yyzkevin/PicoPCMCIA-Breakout/hw/Breakout.step

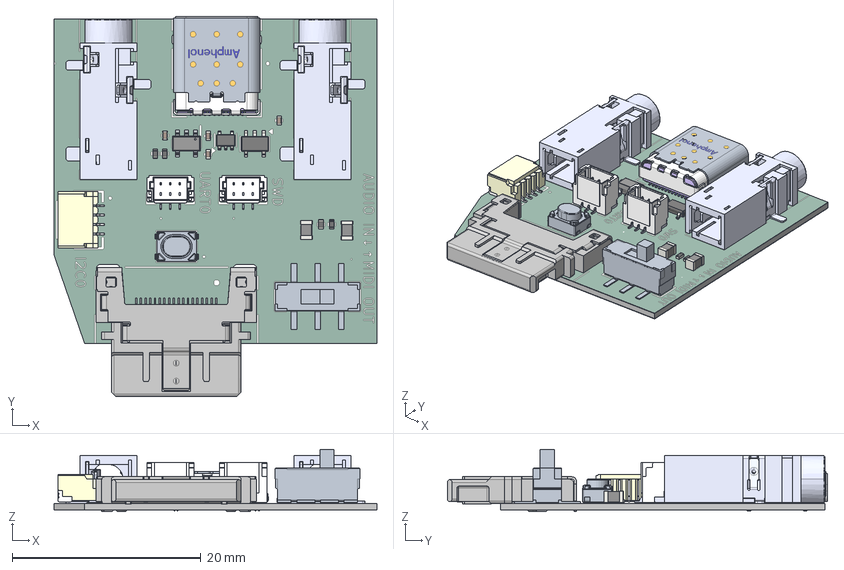
[picture p1: CAD file, 2026-10-23]
hw/Breakout.step
34.2 x 40.3 x 6.60 mm
SJ-3523-SMT-TR x 2
ST60X-18S
BMxxB-SRSS-TB(LF)(SN)_03 x 2
R_0402_1005Metric x 4
PinsArrayL
PinsArrayR
L_0805_2012Metric x 2
C_0402_1005Metric x 4
SOT-353_SC-70-5
Breakout 1.15
TSOT-23-5
664_12401610E4%232A
JS202011SCQN
SM04B-SRSS-TB
Breakout_silkscreen
Breakout_soldermask
Breakout_PCB
