yyzkevin/PicoPCMCIA-Breakout/hw/Breakout.kicad_pcb

## KiCad design hw/Breakout.kicad_pcb (2026-11-13)

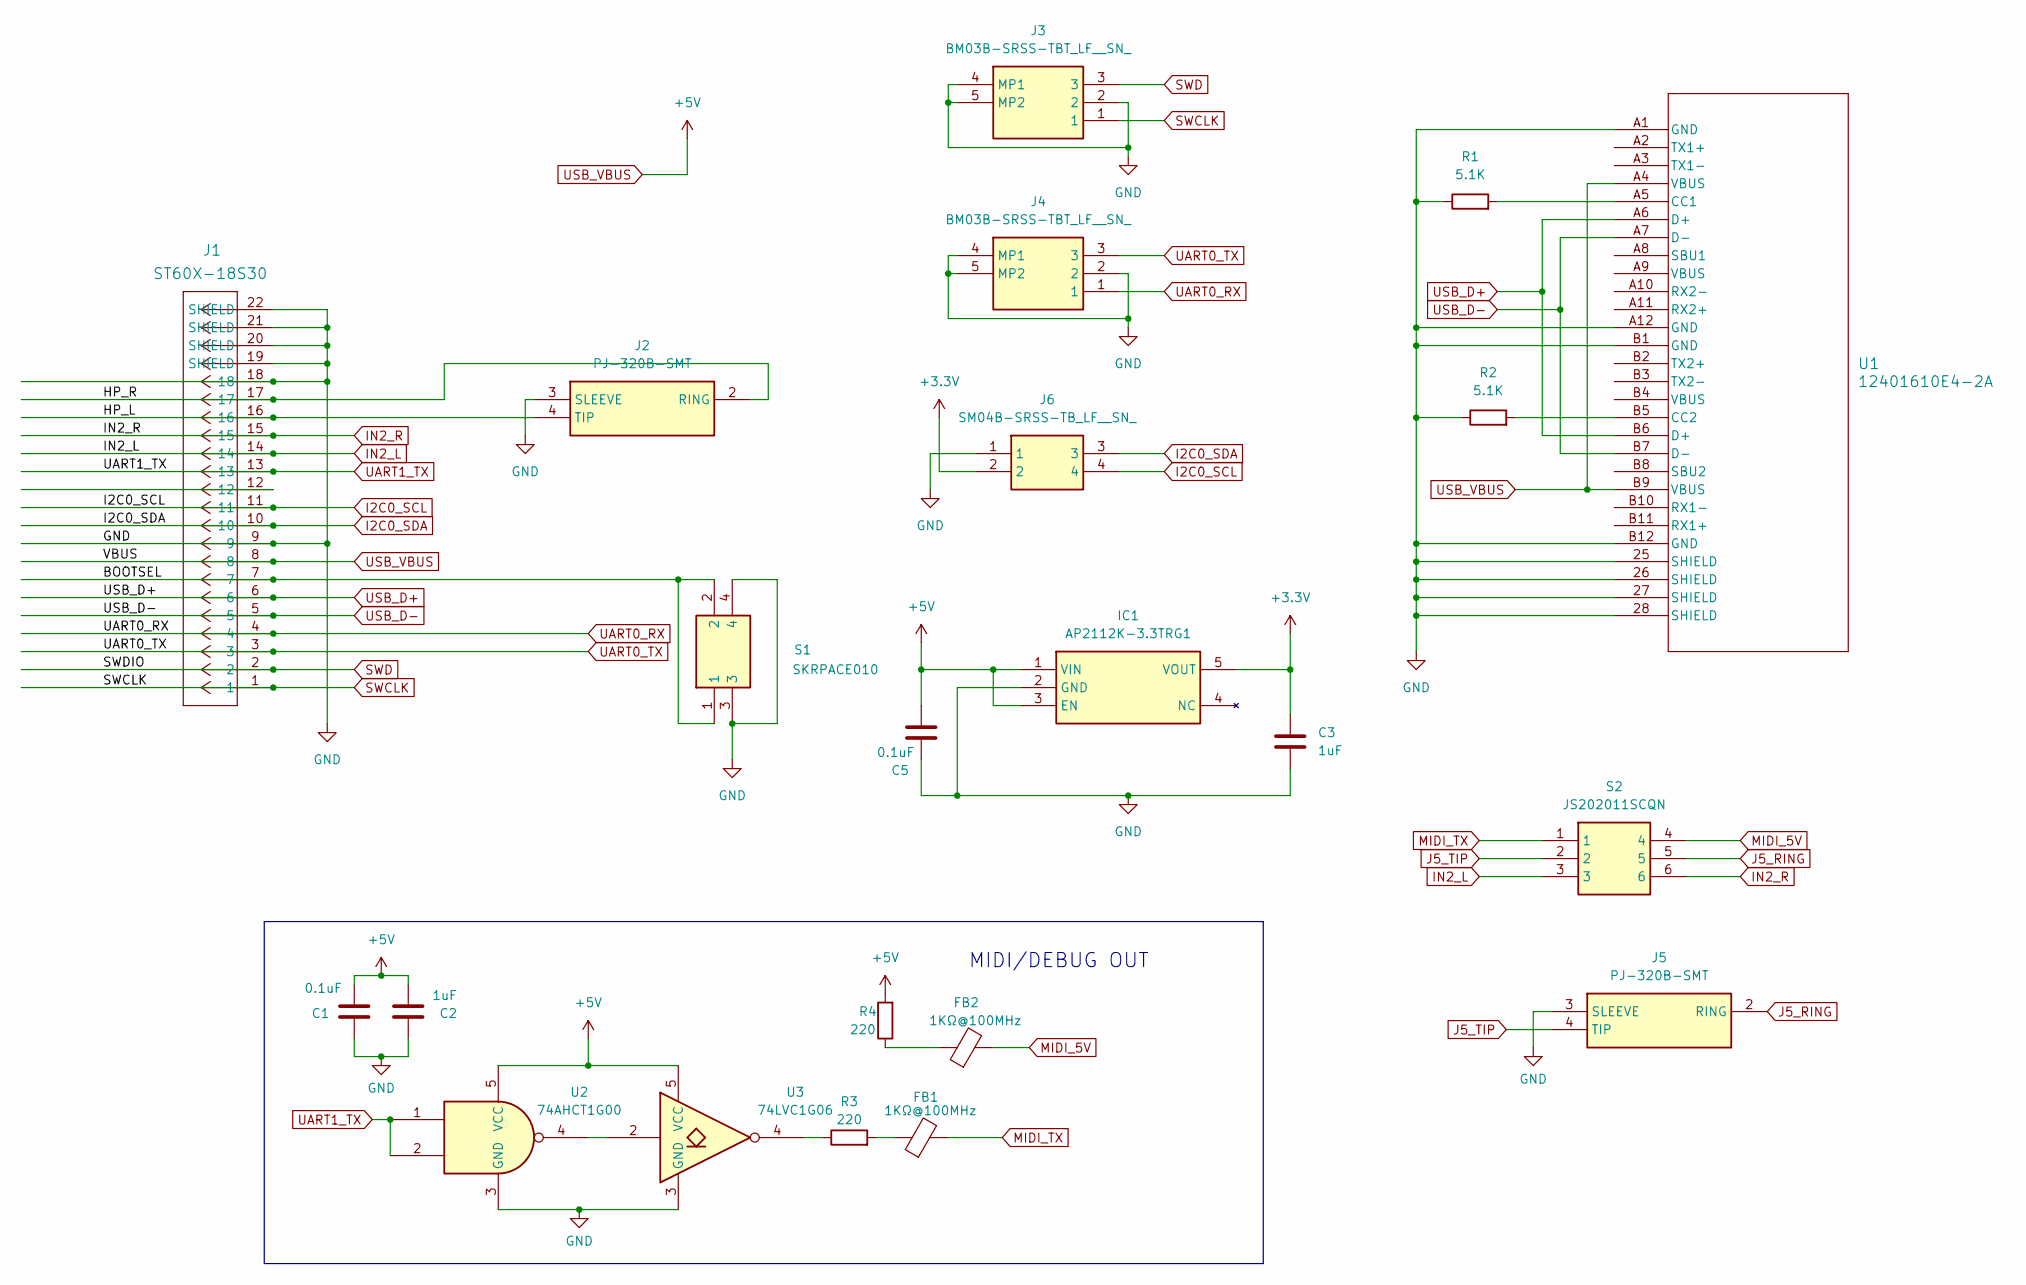
[picture p2: schematic Breakout.kicad_sch]

Parts:
C1, C5: 0.1uF; C_0402_1005Metric; LCSC C1525
C2, C3: 1uF; C_0402_1005Metric; LCSC C52923
FB1, FB2: 1KΩ@100MHz; L_0805_2012Metric; LCSC C85835
IC1: AP2112K-3.3TRG1; SOT95P285X140-5N; Mouser Part Number 621-AP2112K-3.3TRG1
J1: ST60X-18S30; CONN18_0X-18S30_HIR; LCSC C21136285
J2, J5: PJ-320B-SMT; Manufacturer_Part_Number PJ-320B-SMT; LCSC C2884998
J3, J4: BM03B-SRSS-TBT_LF__SN_; BM03BSRSSTBTLFSN; Mouser Part Number N/A
J6: SM04B-SRSS-TB_LF__SN_; SM04B-SRSS-TB_LFSN_; Mouser Part Number 306-SM04BSRSSTBLFSN
R1, R2: 5.1K; R_0402_1005Metric; LCSC C25905
R3, R4: 220; R_0402_1005Metric; LCSC C25091
S1: SKRPACE010; SMT_4.2X3.2_; Mouser Part Number 688-SKRPACE010
S2: JS202011SCQN; Mouser Part Number 611-JS202011SCQN
U1: 12401610E4-2A; 12401610E4-2A_AMP; LCSC C5119948
U2: 74AHCT1G00; SOT-353_SC-70-5; LCSC C7483
U3: 74LVC1G06; TSOT-23-5; LCSC C840103

Connections:
+3.3V: C3.1, IC1.5 (VOUT), J6.2
/BOOTSEL: J1.7, S1.1, S1.2
/HP_L: J1.16, J2.4 (TIP)
/HP_R: J1.17, J2.2 (RING)
GND: C1.2, C2.2, C3.2, C5.2, IC1.2 (GND), J1.9, J1.18, J1.19 (SHIELD), J1.20 (SHIELD), J1.21 (SHIELD), J1.22 (SHIELD), J2.3 (SLEEVE), J3.2, J3.4 (MP1), J3.5 (MP2), J4.2, J4.4 (MP1), J4.5 (MP2), J5.3 (SLEEVE), J6.1, R1.1, R2.1, S1.3, S1.4, U1.25 (SHIELD), U1.26 (SHIELD), U1.27 (SHIELD), U1.28 (SHIELD), U1.A1 (GND), U1.A12 (GND), U1.B1 (GND), U1.B12 (GND), U2.3 (GND), U3.3 (GND)
I2C0_SCL: J1.11, J6.4
I2C0_SDA: J1.10, J6.3
IN2_L: J1.14, S2.3
IN2_R: J1.15, S2.6
J5_RING: J5.2 (RING), S2.5
J5_TIP: J5.4 (TIP), S2.2
MIDI_5V: FB2.2, S2.4
MIDI_TX: FB1.2, S2.1
unnamed: FB1.1, R3.2
unnamed: FB2.1, R4.1
unnamed: R3.1, U3.4
unnamed: R1.2, U1.A5 (CC1)
unnamed: R2.2, U1.B5 (CC2)
unnamed: U2.4, U3.2
SWCLK: J1.1, J3.1
SWD: J1.2, J3.3
UART0_RX: J1.4, J4.1
UART0_TX: J1.3, J4.3
UART1_TX: J1.13, U2.1, U2.2
USB_D+: J1.6, U1.A6 (D+), U1.B6 (D+)
USB_D-: J1.5, U1.A7 (D-), U1.B7 (D-)
USB_VBUS: C1.1, C2.1, C5.1, IC1.1 (VIN), IC1.3 (EN), J1.8, R4.2, U1.A4 (VBUS), U1.B9 (VBUS), U2.5 (VCC), U3.5 (VCC)

Notes on the sheet:
MIDI/DEBUG OUT

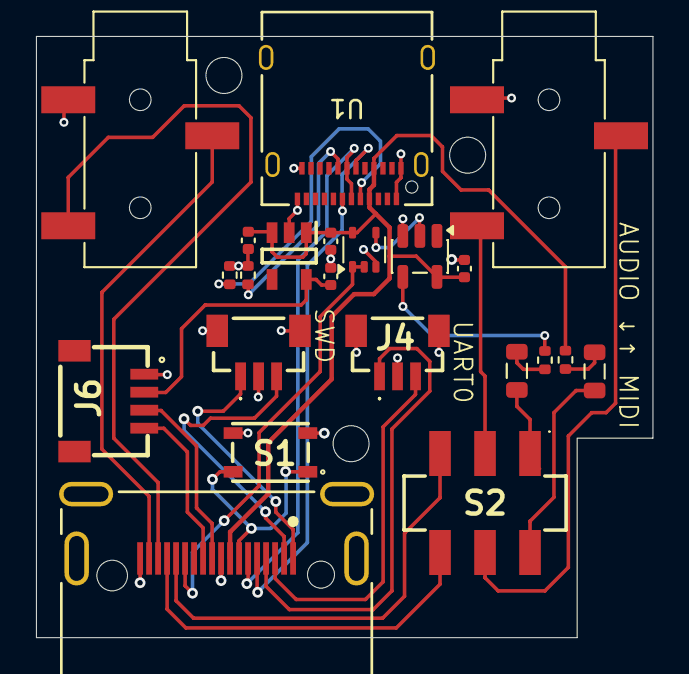
[picture p3: board Breakout.kicad_pcb from above]

Board: 2 copper layers, 34.2 x 33.4 mm, 22 parts (0 on the bottom side), 27 nets.
