yyzkevin/PicoPCMCIA-Breakout/(commit log)

2026-01-06 Initial Commit
    Work in progress breakout board
2026-01-06 Add connector details and pinout to README
    Added detailed information about connectors and pinout for PicoPCMCIA External I/O.
2026-10-23 hw: LCSC numbers fixed for JLC stock (breakout)
    Out of stock / wrong part:
    - U2 74LVC1G00: C2878883 (DCKT, 1 in stock) -> C8185 SN74LVC1G00DCKR
    - IC1 AP2112K-3.3TRG1: C23380830 (TECH PUBLIC clone) -> C51118 (Diodes,
    the part already held in the JLC private stock)
    - J1 ST60X-18S(30): had no LCSC -> C21136285 (held in private stock)
    - FB1/FB2 1k@100MHz: C16903 was BLM21PG300 (30 ohm) -> C85835 BLM21AG102SN1D
    - R3/R4 220: C114764 was 200 ohm -> C25091 (220 ohm, basic)
    Extended -> basic:
    - C1/C2/C5 0.1uF 0402 -> C1525; C3 1uF 0402 -> C52923; R1/R2 5.1K -> C25905
    J2/J5 keep SJ-3523-SMT-TR (C4991872, 0 at JLC: global sourcing). LCSC is
    now also on the board and in the schematic for every pl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
2026-10-23 hw: J2/J5 -> SJ-3524-SMT-TR (C20182907, in stock); routing to follow
    SJ-3523-SMT-TR (C4991872) has no JLC stock. The SJ-3524 is the same
    Same Sky SJ-352X-SMT body with a tip-switch terminal, pin 4, behind the
    jack: footprint BreakoutLibrary:SJ3524SMTTR, pad 4 left unconnected.
    Not routed yet. Pad 4 sits on J6 pad 1 and the +3.3V/GND tracks and via
    behind J2, and on R3/R4/FB2 and their tracks and via behind J5: 43 new DRC
    items, all on pad 4.
    Claude-Session: https://claude.ai/code/session_0133r6nzUahChJ5bbJy715cX
2026-10-23 hw: J2/J5 -> XKB PJ-320B-SMT (C2884998), schematic + library; layout to follow
    No pin behind the jack: three contacts, no switch, all copper inside the
    body length. Rated 500 mA (the SOFNG PJ-320B, C22355831, is rated 25 mA).
    - BreakoutLibrary symbol PJ-320B-SMT: the SJ-3523 symbol, same pin
    positions so the wiring is untouched, renumbered to XKB's pins:
    3 sleeve, 2 ring, 4 tip (XKB X-PJ-320B-SMT rev A1; pins match SOFNG's
    A/B/C and the plug's sleeve/ring/tip order front to back)
    - BreakoutLibrary.pretty/PJ-320B-SMT: pads 1.5 x 3.0 at (-3,+4) 3,
    (-1,-4) 2, (+4,+4) 4; NPTH 1.2 at (+-3, 0); origin = peg midpoint;
    plug enters from -X
    - BreakoutLibrary.3dshapes/PJ-320B-SMT.step (+ .p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
2026-10-23 hw: PJ-320B-SMT courtyard follows the body and pads (was a 14.5 x 11.5 box)
    0.25 mm around the 6 mm body, the 5 mm nose and each of the three side
    pads, instead of one rectangle spanning the full pad width along the whole
    body.
    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
2026-11-13 hw: U2 -> 74AHCT1G00 (C7483), C2 -> 1uF (C52923); schematic + db
    U2 runs from USB_VBUS (5 V) but its input is MIDI_TX straight from the
    RP2354 (3.3 V). 74LVC1G00 needs VIH >= 0.7 x VCC = 3.5 V at 5 V; the AHCT
    part has TTL inputs (VIH 2.0 V). Same TI SC-70-5 (DCK) package and pinout.
    C2 is IC1's input capacitor (1.4 mm from VIN); the AP2112K wants 1 uF there.
    Same 0402 footprint and the same basic part as C3, so no new BOM line.
    PCB not touched: Update PCB from Schematic carries the values and LCSC.
    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
2026-11-13 hw: USB-C (12401610E4-2A) shell legs in plated slots, pads 25-28 = GND
    The four shell-leg slots were NPTH with no pad number: shell not soldered,
    not grounded, the receptacle held only by its 24 signal pads. Now plated
    oval pads 25-28 (the symbol's SHIELD pins, already on GND), slot 1.1 x 0.5,
    pad 1.4 x 0.8 per Amphenol 12401610E4#2A sheet 2 (as JLC's own C5119948
    footprint). Signal pads and the two locating pegs unchanged.
    Trial on a board copy (Update Footprints from Library equivalent + refill):
    pads join the GND pour with no unconnected items; the U1 parity, hole and
    edge clearance errors go away; nothing new.
    Claude-Session: ht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
2026-11-13 footprint update
2026-11-13 hw: U2 back to its routed pads; U1 and J1 shell tabs plated on GND
    - U2: "Update Footprints from Library" had swapped in KiCad's current
    SOT-353_SC-70-5 (1.325 mm pads at +-0.8875 instead of 0.65 at +-0.95),
    shorting UART1_TX to a GND via and crowding the VBUS track and U2-out via.
    Restored the footprint the layout was routed against (from cf24878).
    - U1 USB-C: plated shell pads 25-28 had no net; now GND.
    - J1 ST60X-18S: same defect as U1 had. The four shell-tab slots were NPTH
    with no pad numbers (symbol pins 19-22 GND had no pads). Now plated
    oval pads 19-22 on GND, in the library and on the board, matching JLC's
    own C21136285 footprint. Copper size/drill unchanged.
    DRC wit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
2026-11-13 hw: U2 footprint into the project library, so Update Footprints is safe
    KiCad 9.0.7 regenerated Package_TO_SOT_SMD:SOT-353_SC-70-5 with 1.325 mm
    pads (0.65 mm up to 9.0.6). The breakout was routed against the 9.0.6
    pattern, with two vias between the pad rows, so "Update Footprints from
    Library" on 9.0.7 shorted UART1_TX to GND.
    U2 now uses BreakoutLibrary:SOT-353_SC-70-5 = KiCad's 9.0.6 file, which
    is exactly what is on the board (pads and drawing). Schematic and board
    both point at it; footprint name unchanged for the JLC plugin.
    Checked: all 22 footprints on the board now match their library source
    (project library, or KiCad 9.0.7 for the stock passives and TSOT-23-5),
    pads and graphic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
2026-11-13 hw: all breakout footprints now come from the project library
    The last four stock footprints (C_0402_1005Metric, R_0402_1005Metric,
    L_0805_2012Metric, TSOT-23-5) copied verbatim from KiCad 9.0.7 into
    BreakoutLibrary.pretty; the 11 parts using them point there in the
    schematic and on the board. Names unchanged (JLC plugin rotation rules
    match on them). A KiCad library update can no longer change a footprint
    under the routed board, as 9.0.7 did with the SC-70-5.
    All 22 footprints match the project library, pads and drawing. DRC with
    parity and refill: 0 unconnected, no shorts or clearance errors; as
    before, J5/U3 and J3/J4 courtyard overlaps and silk warnings only.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
2026-11-13 hw: breakout gets its own JLC rotation rules (project.db correction table)
    The breakout's project.db had no correction table, so the plugin fell back
    to the machine-wide rules, which are not in the repo. It now carries the
    main board's table plus one new rule:
    PJ-320B-SMT +90 (J2, J5)
    Every placed part checked against JLC's own footprint for its LCSC number:
    IC1 -90 (AP2112K rule), U2 180 (^SOT-353), U3 180, J2/J5 +90, all others 0.
    J1, U1, J3, J4, J6, S1, S2 fit only one way round, at 0.
    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
2026-11-13 hw: J2 headphone jack: left on tip, right on ring (schematic only)
    The card puts HPL on connector pin 16 and HPR on pin 17 (v4.4, README).
    Since the October "revised design" the breakout took pin 16 to J2's ring
    and pin 17 to its tip, so headphones were left/right reversed; the
    January design had left on tip. All three sources (PCM, SAM2695 MIDI,
    line-in) are mixed inside the codec and arrive left-on-HPL, so the fix is
    at the jack.
    Schematic: J1.16 (HP_L) -> J2 pin 4 TIP, J1.17 (HP_R) -> J2 pin 2 RING.
    Netlist diff = exactly those two pins. J5 untouched.
    Board NOT updated: Update PCB from Schematic, then reroute the two
    headphone tracks at J2 (pads 2 and 4 swap nets).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
